bclswl0827/pebble/hardware/Pebble.csv

Reference | Qty | Value | DNP | Exclude from BOM | Exclude from Board | Exclude from Simulation | Exclude from Position Files | Footprint | Datasheet
AE1 | 1 | Antenna_Loop |  |  |  |  | ${EXCLUDE_FROM_POS_FILES} | RF_Antenna:Texas_SWRA117D_2.4GHz_Left
BT1 | 1 | BS-CR2032-8 |  |  |  |  | ${EXCLUDE_FROM_POS_FILES} | Pebble:BAT-SMD_BS-CR2032-8
C1 | 1 | 10uF |  |  |  |  | ${EXCLUDE_FROM_POS_FILES} | Capacitor_SMD:C_0603_1608Metric
C2 | 1 | 1uF |  |  |  |  | ${EXCLUDE_FROM_POS_FILES} | Capacitor_SMD:C_0603_1608Metric
C3,C4 | 2 | 1.8pF | DNP |  |  |  | ${EXCLUDE_FROM_POS_FILES} | Capacitor_SMD:C_0603_1608Metric
C5 | 1 | 0.1uF | DNP |  |  |  | ${EXCLUDE_FROM_POS_FILES} | Capacitor_SMD:C_0603_1608Metric
C6 | 1 | 0.1uF |  |  |  |  | ${EXCLUDE_FROM_POS_FILES} | Capacitor_SMD:C_0603_1608Metric
D1 | 1 | GREEN |  |  |  |  | ${EXCLUDE_FROM_POS_FILES} | LED_SMD:LED_0603_1608Metric
D2 | 1 | YELLOW |  |  |  |  | ${EXCLUDE_FROM_POS_FILES} | LED_SMD:LED_0603_1608Metric
D3 | 1 | RED |  |  |  |  | ${EXCLUDE_FROM_POS_FILES} | LED_SMD:LED_0603_1608Metric
L1 | 1 | 2.2uH |  |  |  |  | ${EXCLUDE_FROM_POS_FILES} | Inductor_SMD:L_0603_1608Metric
L2 | 1 | 3.3nH |  |  |  |  | ${EXCLUDE_FROM_POS_FILES} | Inductor_SMD:L_0603_1608Metric
R1,R2 | 2 | 10k |  |  |  |  | ${EXCLUDE_FROM_POS_FILES} | Resistor_SMD:R_0603_1608Metric
R3,R4,R5 | 3 | 1k |  |  |  |  | ${EXCLUDE_FROM_POS_FILES} | Resistor_SMD:R_0603_1608Metric
TP1 | 1 | GND |  |  |  |  | ${EXCLUDE_FROM_POS_FILES} | TestPoint:TestPoint_Pad_D1.0mm
TP2 | 1 | SWCLK |  |  |  |  | ${EXCLUDE_FROM_POS_FILES} | TestPoint:TestPoint_Pad_D1.0mm
TP3 | 1 | SWDIO |  |  |  |  | ${EXCLUDE_FROM_POS_FILES} | TestPoint:TestPoint_Pad_D1.0mm
U1 | 1 | DA14531-00000FX2 |  |  |  |  | ${EXCLUDE_FROM_POS_FILES} | Pebble:FCGQFN-24_L3.0-W2.2-P0.40-BL | https://item.szlcsc.com/datasheet/DA14531-00000FX2/522793.html
U2 | 1 | LIS2DW12TR |  |  |  |  | ${EXCLUDE_FROM_POS_FILES} | Package_LGA:LGA-12_2x2mm_P0.5mm | https://item.szlcsc.com/datasheet/LIS2DW12TR-HXY/48681526.html
U3 | 1 | W25X20CLSN | DNP |  |  |  | ${EXCLUDE_FROM_POS_FILES} | Package_SO:SOIC-8_3.9x4.9mm_P1.27mm | https://www.winbond.com/resource-files/w25x20cl_revf%2020150806.pdf
Y1 | 1 | 32MHz |  |  |  |  | ${EXCLUDE_FROM_POS_FILES} | Crystal:Crystal_SMD_SeikoEpson_TSX3225-4Pin_3.2x2.5mm
