bclswl0827/pebble/hardware/Pebble.pdf

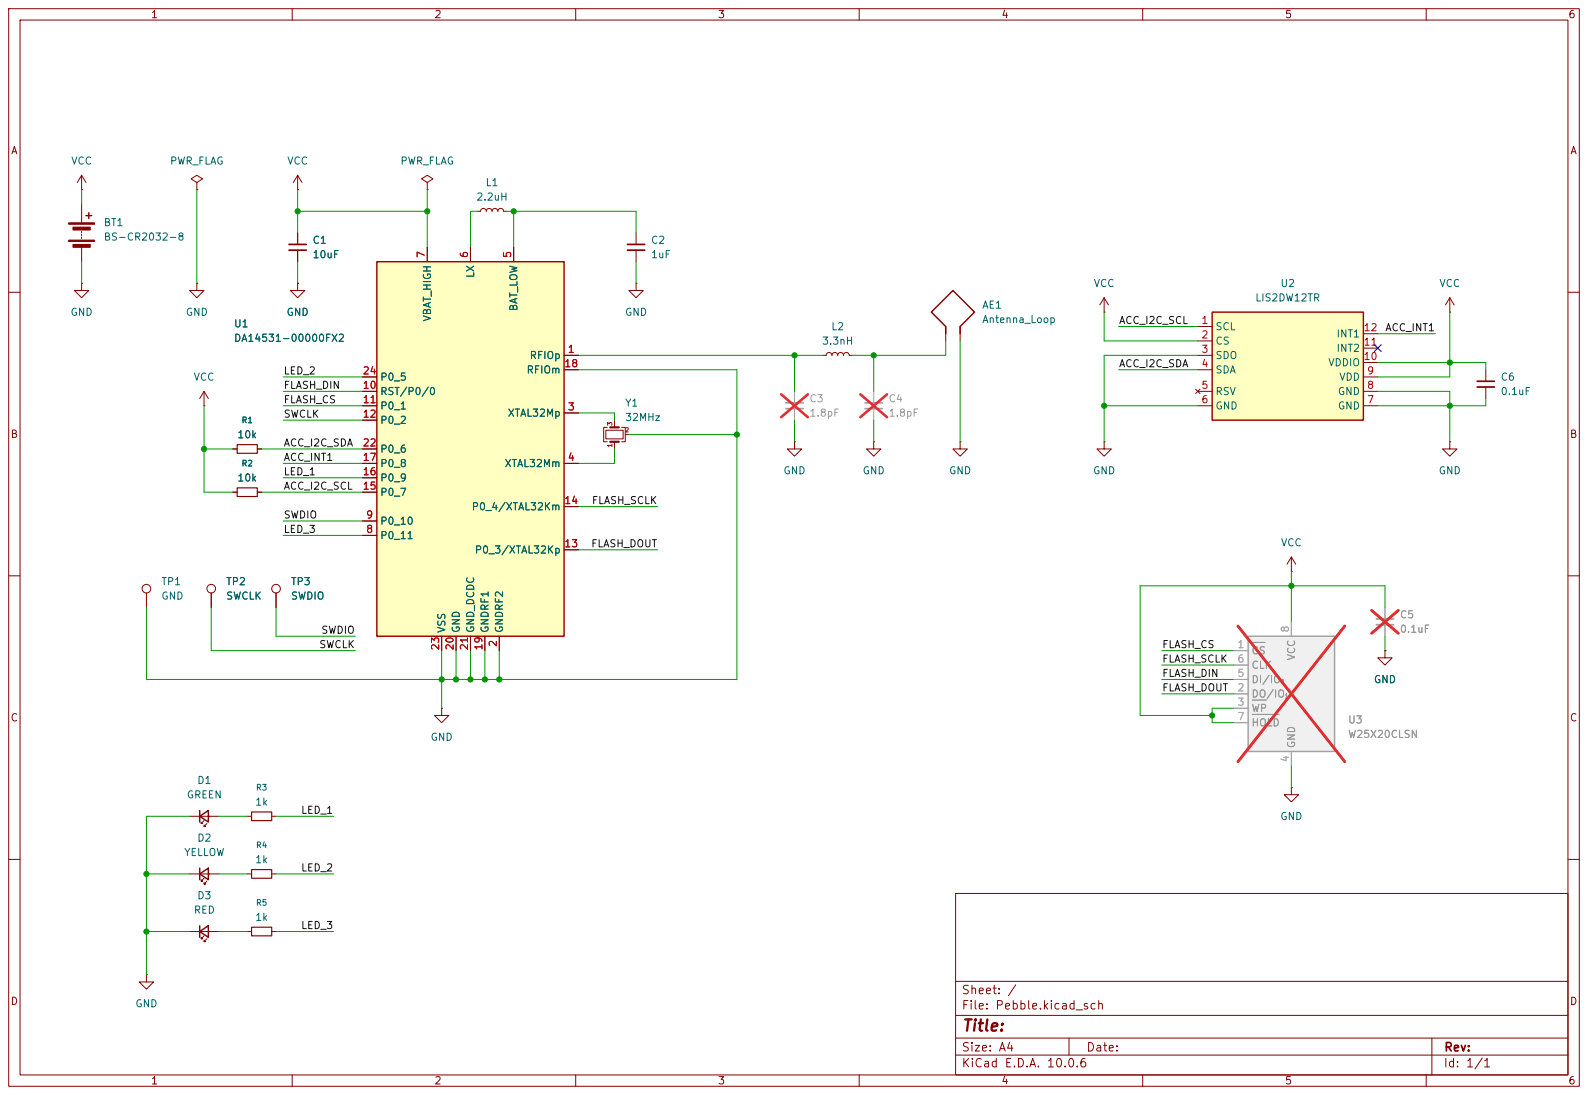
[picture p12: page 1]

7 P0_11 8 P0_10 9 RST/P0/0 10 P0_1 11 P0_2 12 P0_3/XTAL32Kp 13 P0_4/XTAL32Km 14 P0_7 15 P0_9 16 P0_8 17 RFIOm 18 GNDRF1 19 GND 20 GND_DCDC 21 P0_6 22 VSS 23 P0_5 24 U1DA14531-00000FX2 GND AE1

7 P0_11 8 P0_10 9 RST/P0/0 10 P0_1 11 P0_2 12 P0_3/XTAL32Kp 13 P0_4/XTAL32Km 14 P0_7 15 P0_9 16 P0_8 17 RFIOm 18 GNDRF1 19 GND 20 GND_DCDC 21 P0_6 22 VSS 23 P0_5 24 GND

4 DI/IO0 5 CLK 6 HOLD 7 VCC

Size: A4 | Rev:
KiCad E.D.A. 10.0.6 | Id: 1/1
