bclswl0827/pebble/hardware/Pebble.kicad_pcb

## KiCad design hardware/Pebble.kicad_pcb (2026-11-08)

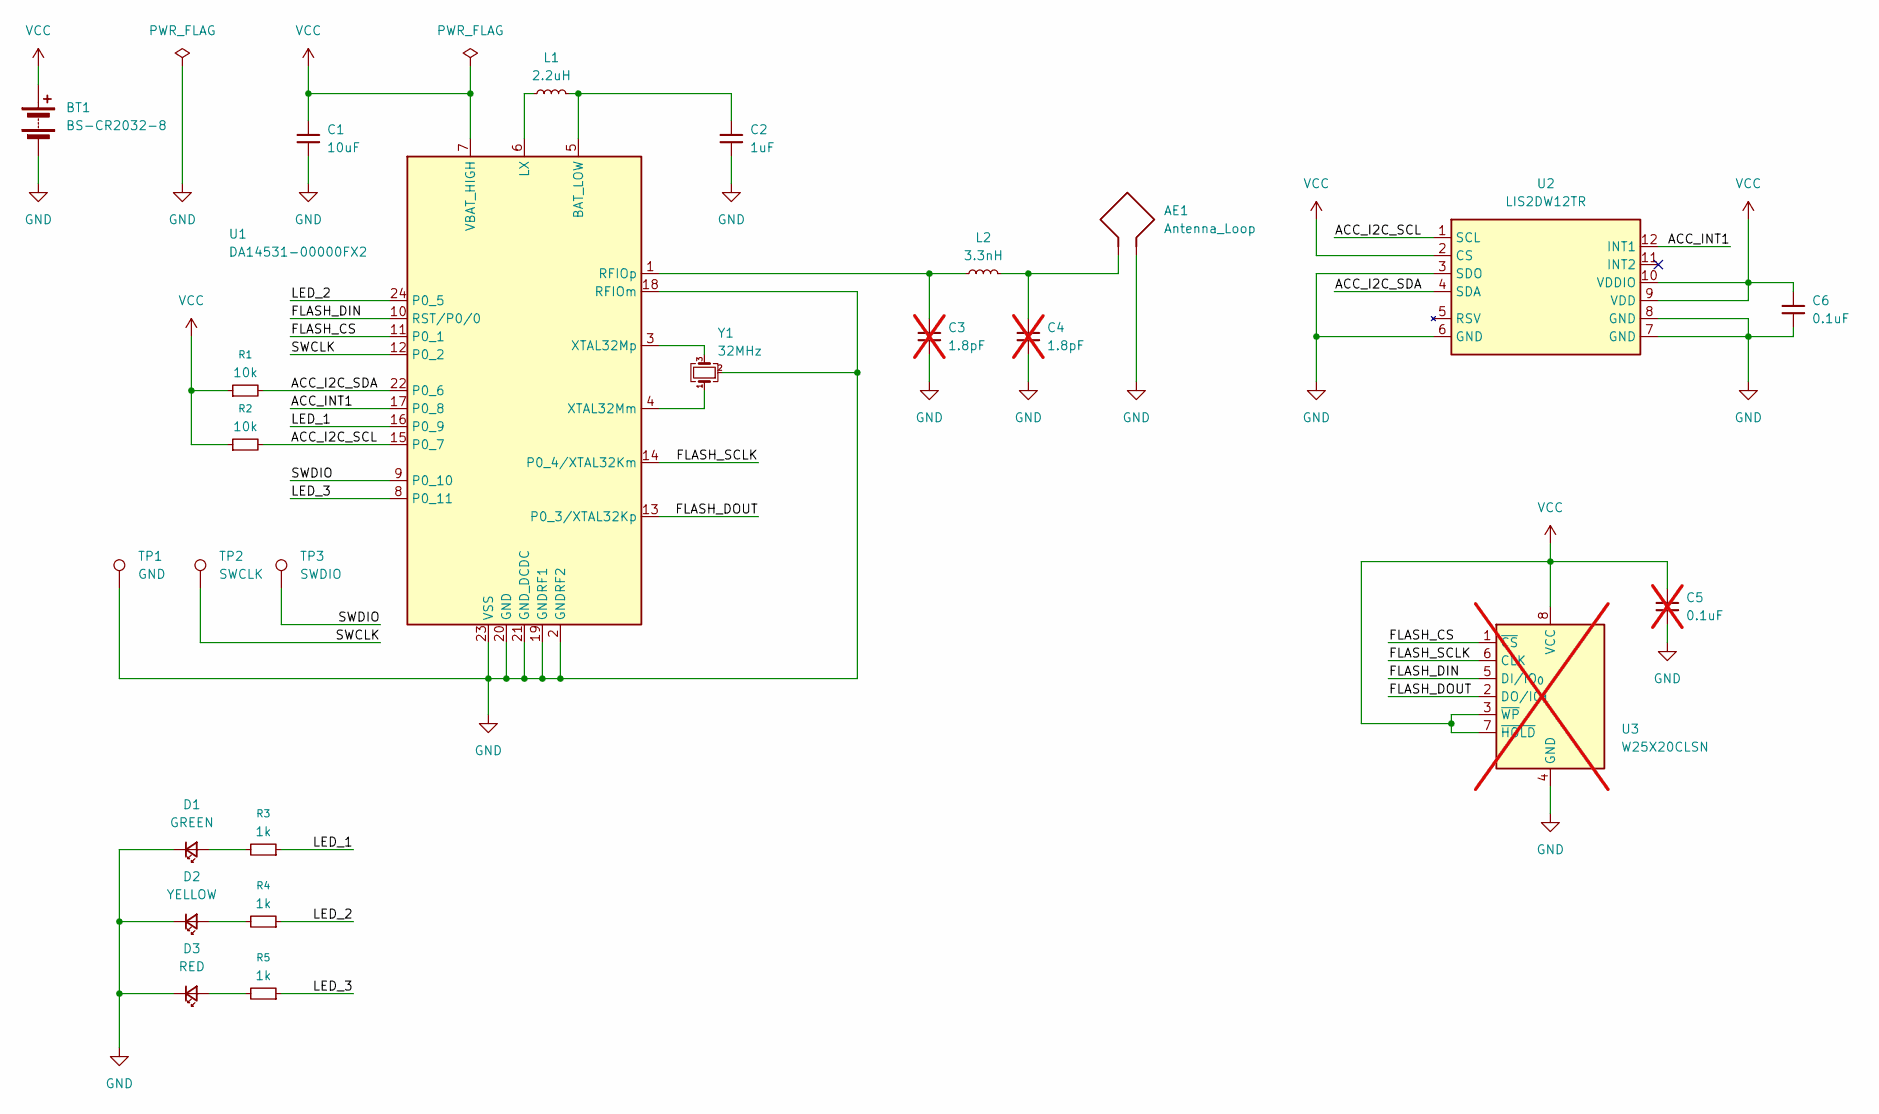
[picture p13: schematic Pebble.kicad_sch]

Parts:
AE1: Antenna_Loop; Texas_SWRA117D_2.4GHz_Left
BT1: BS-CR2032-8; BAT-SMD_BS-CR2032-8
C1: 10uF; C_0603_1608Metric
C2: 1uF; C_0603_1608Metric
C3, C4: 1.8pF; C_0603_1608Metric; not fitted
C5: 0.1uF; C_0603_1608Metric; not fitted
C6: 0.1uF; C_0603_1608Metric
D1: GREEN; LED_0603_1608Metric
D2: YELLOW; LED_0603_1608Metric
D3: RED; LED_0603_1608Metric
L1: 2.2uH; L_0603_1608Metric
L2: 3.3nH; L_0603_1608Metric
R1, R2: 10k; R_0603_1608Metric
R3, R4, R5: 1k; R_0603_1608Metric
TP1: GND; TestPoint_Pad_D1.0mm
TP2: SWCLK; TestPoint_Pad_D1.0mm
TP3: SWDIO; TestPoint_Pad_D1.0mm
U1: DA14531-00000FX2; FCGQFN-24_L3.0-W2.2-P0.40-BL
U2: LIS2DW12TR; LGA-12_2x2mm_P0.5mm
U3: W25X20CLSN; SOIC-8_3.9x4.9mm_P1.27mm; not fitted
Y1: 32MHz; Crystal_SMD_SeikoEpson_TSX3225-4Pin_3.2x2.5mm

Connections:
/ACC_I2C_SCL: R2.2, U1.15 (P0_7), U2.1 (SCL)
/ACC_I2C_SDA: R1.2, U1.22 (P0_6), U2.4 (SDA)
/ACC_INT1: U1.17 (P0_8), U2.12 (INT1)
/FLASH_CS: U1.11 (P0_1), U3.1 (~CS)
/FLASH_DIN: U1.10 (RST/P0/0), U3.5 (DI/IO_{0})
/FLASH_DOUT: U1.13 (P0_3/XTAL32Kp), U3.2 (DO/IO_{1})
/FLASH_SCLK: U1.14 (P0_4/XTAL32Km), U3.6 (CLK)
/LED_1: R3.1, U1.16 (P0_9)
/LED_2: R4.1, U1.24 (P0_5)
/LED_3: R5.1, U1.8 (P0_11)
/SWCLK: TP2.1 (1_1), U1.12 (P0_2)
/SWDIO: TP3.1 (1_1), U1.9 (P0_10)
GND: AE1.2, BT1.2 (-), C1.2, C2.2, C3.2, C4.2, C5.2, C6.2, D1.1 (K), D2.1 (K), D3.1 (K), TP1.1 (1_1), U1.2 (GNDRF2), U1.18 (RFIOm), U1.19 (GNDRF1), U1.20 (GND), U1.21 (GND_DCDC), U1.23 (VSS), U2.3 (SDO), U2.6 (GND), U2.7 (GND), U2.8 (GND), U3.4 (GND), Y1.2 (G), Y1.4 (G)
unnamed: AE1.1, C4.1, L2.2
unnamed: D1.2 (A), R3.2
unnamed: D2.2 (A), R4.2
unnamed: D3.2 (A), R5.2
unnamed: C2.1, L1.2, U1.5 (BAT_LOW)
unnamed: L1.1, U1.6 (LX)
unnamed: C3.1, L2.1, U1.1 (RFIOp)
unnamed: U1.4 (XTAL32Mm), Y1.1
unnamed: U1.3 (XTAL32Mp), Y1.3
VCC: BT1.1 (+), C1.1, C5.1, C6.1, R1.1, R2.1, U1.7 (VBAT_HIGH), U2.2 (CS), U2.9 (VDD), U2.10 (VDDIO), U3.3 (~WP), U3.7 (~HOLD), U3.8 (VCC)

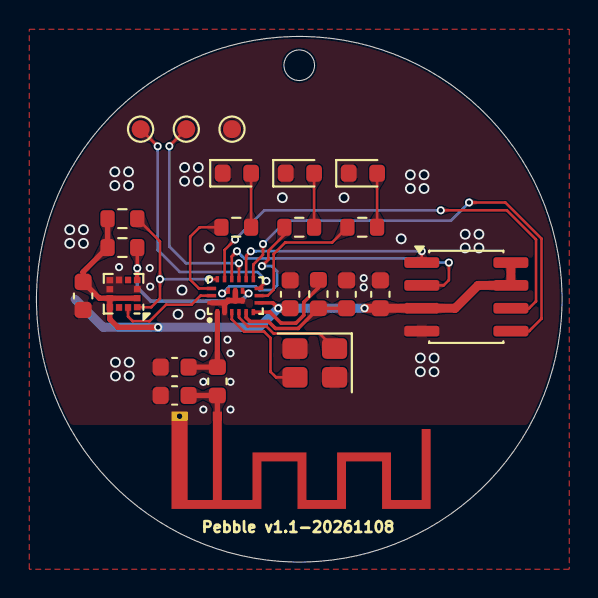
[picture p14: board Pebble.kicad_pcb from above]

Board: 2 copper layers, 29.2 x 29.2 mm, 25 parts (1 on the bottom side), 23 nets.
