bclswl0827/pebble/firmware/include/user_custs_config.h

#ifndef USER_CUSTS_CONFIG_H
#define USER_CUSTS_CONFIG_H

/* Included by name from the SDK (app.c, app_customs.c, app_default_handlers.c). */
#include "app_prf_types.h"

extern const struct cust_prf_func_callbacks cust_prf_funcs[];

#endif
