bclswl0827/pebble/firmware/include/user_modules_config.h

#ifndef USER_MODULES_CONFIG_H
#define USER_MODULES_CONFIG_H

#define EXCLUDE_DLG_GAP             (0)
#define EXCLUDE_DLG_TIMER           (0)
/* app_easy_wakeup() defers the accelerometer interrupt to the kernel. */
#define EXCLUDE_DLG_MSG             (0)
#define EXCLUDE_DLG_SEC             (1)
#define EXCLUDE_DLG_DISS            (1)
#define EXCLUDE_DLG_PROXR           (1)
#define EXCLUDE_DLG_BASS            (1)
#define EXCLUDE_DLG_FINDL           (1)
#define EXCLUDE_DLG_FINDT           (1)
#define EXCLUDE_DLG_SUOTAR          (1)
#define EXCLUDE_DLG_CUSTS1          (0)
#define EXCLUDE_DLG_CUSTS2          (1)

#endif
