bclswl0827/pebble/(commit log)

2026-10-25 init: upload PCB design files
    [Pebble-B_Cu.gbr, Pebble-B_Mask.gbr, Pebble-B_Paste.gbr, Pebble-B_Silkscreen.gbr, Pebble-Edge_Cuts.gbr, Pebble-F_Cu.gbr, Pebble-F_Mask.gbr, Pebble-F_Paste.gbr]
2026-11-08 feat: full firmware support
    [Pebble-B_Cu.gbr, Pebble-B_Mask.gbr, Pebble-B_Paste.gbr, Pebble-B_Silkscreen.gbr, Pebble-Edge_Cuts.gbr, Pebble-F_Cu.gbr, Pebble-F_Mask.gbr, Pebble-F_Paste.gbr]
2026-11-08 fix: display real battery level
    [Pebble-B_Cu.gbr, Pebble-B_Mask.gbr, Pebble-B_Paste.gbr, Pebble-B_Silkscreen.gbr, Pebble-Edge_Cuts.gbr, Pebble-F_Cu.gbr, Pebble-F_Mask.gbr, Pebble-F_Paste.gbr]
